Fred72z/ZX81/VP140/Clavier/Readme.md

# Clavier

Le Clavier minitel est très différent du clavier du ZX81. Aussi la disposition des touches est différentes. L'utilisation d'un PIC pour reproduire la matrice du clavier du ZX permet de rediriger certaines combinaisons de touches afin de simplificer l'utilisation du clavier minitel.

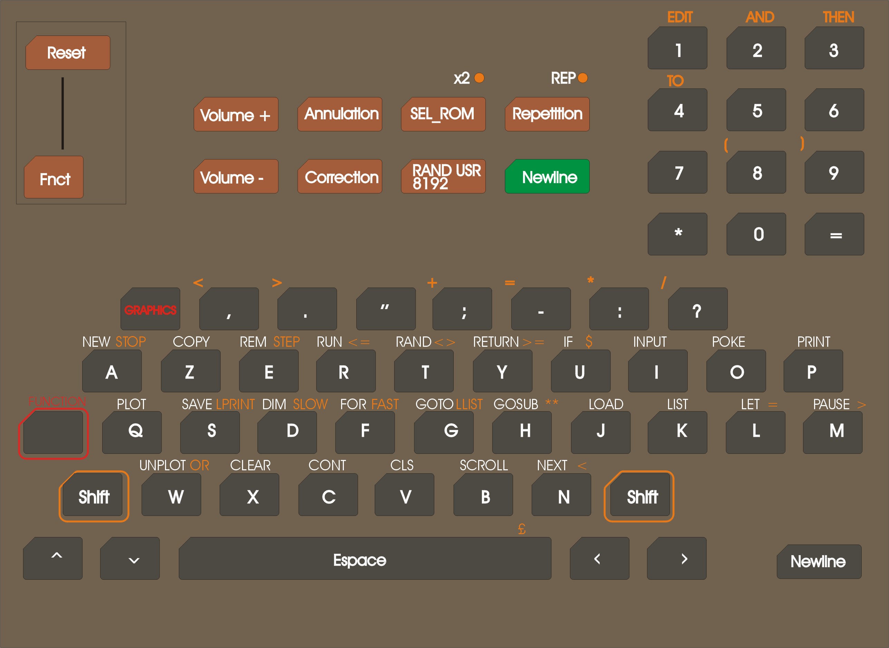
[picture p9: VP140/Clavier/map_clavier_minitel.jpg]
Map clavier Optional Title


Un appui simultané sur les touches Fcnt et Connexion/Fin permet de faire un RESET du ZX (appui prolongé).
Une petite led a été ajoutée au dessus de la touche Répétition pour indiquer l'activation de ce mode (désactivé à la mise sous tension).

# Ajout de la led

La led utilisée est une led 2mm à canon long (visible sur la photo). Il suffit de percer un trou de 2mm (1.9mm puis 2mm pour être juste à la cote).
Elle est recouverte de gaine thermorétractable pour éviter la lumière parasite sur les côtés. La résistances de limitation du courant doit être ajustée en fonction de la led choisie. Ici la résistance vaut 15k (La résistance est maintenant placée sur la platine principale).

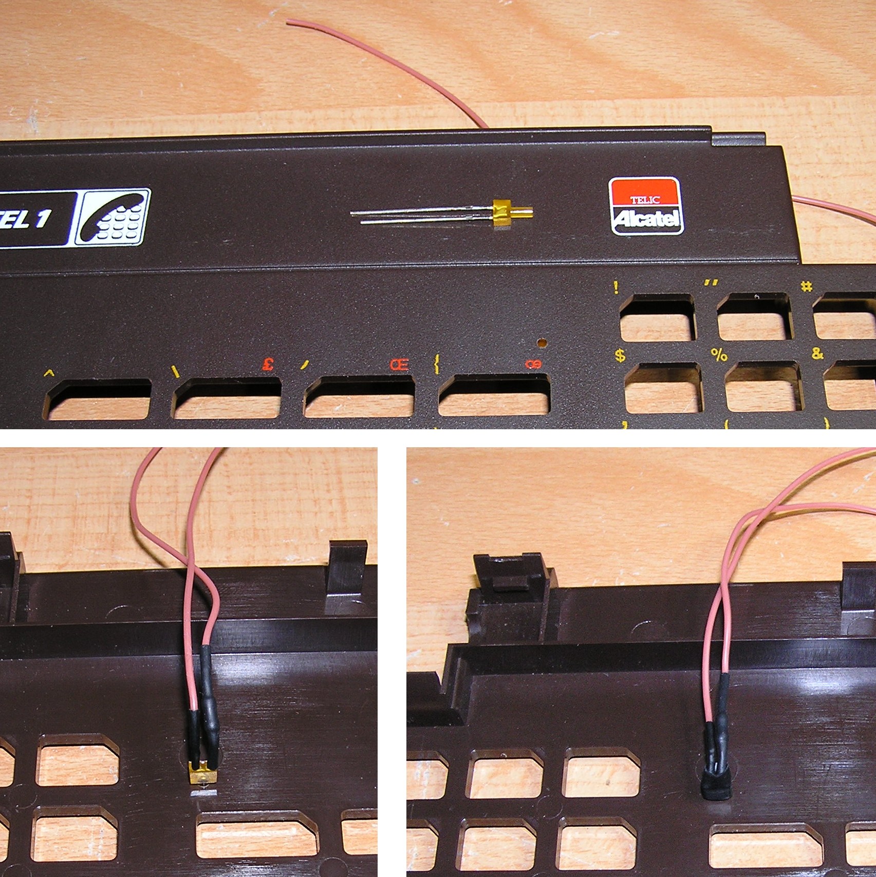
[picture p10: VP140/Clavier/led_clavier.jpg]
Led clavier Optional Title


# Rev 1.3
Pour la révision 1.3, il y a quelques changement:
- Une 2ème led a été ajoutée pour choisir 2 versions de la ROM du ZX.
- La touche Annulation permet d'effacer 10 caractères
- La touche RAND USR a été décalée
