Fred72z/ZX81/VP140/Cartouches/Readme.md

# Cartouches ROM

Les cartouches ROM ont une capacité de 256Ko (27c020 ou mieux W27E020). Elles prennent place dans la zone [$2000-$3FFF], soit 32 banques de 8Ko.
Le choix de la banque se fait par un écriture en mémoire à l'adresse $FFFF.

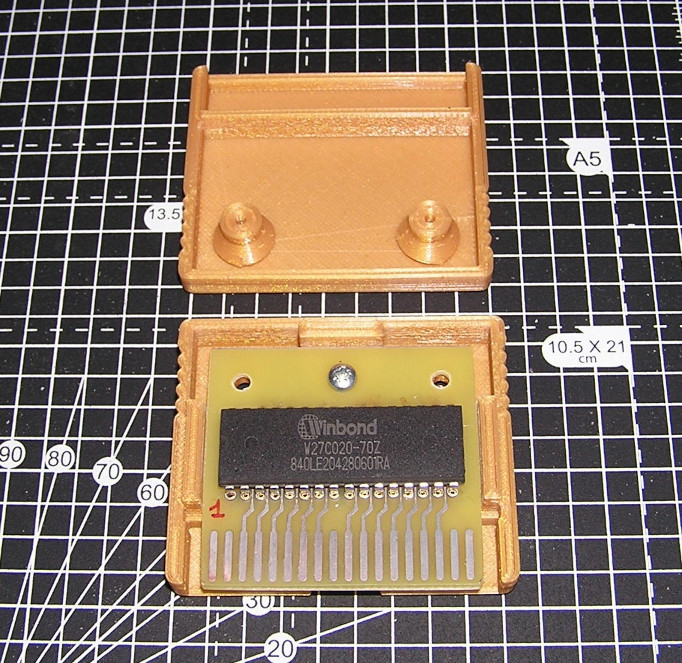
[picture p11: VP140/Cartouches/cartouche.jpg]
Cartouche Optional Title


# Cartouche N1
Cette première cartouche propose 18 programmes de jeux.

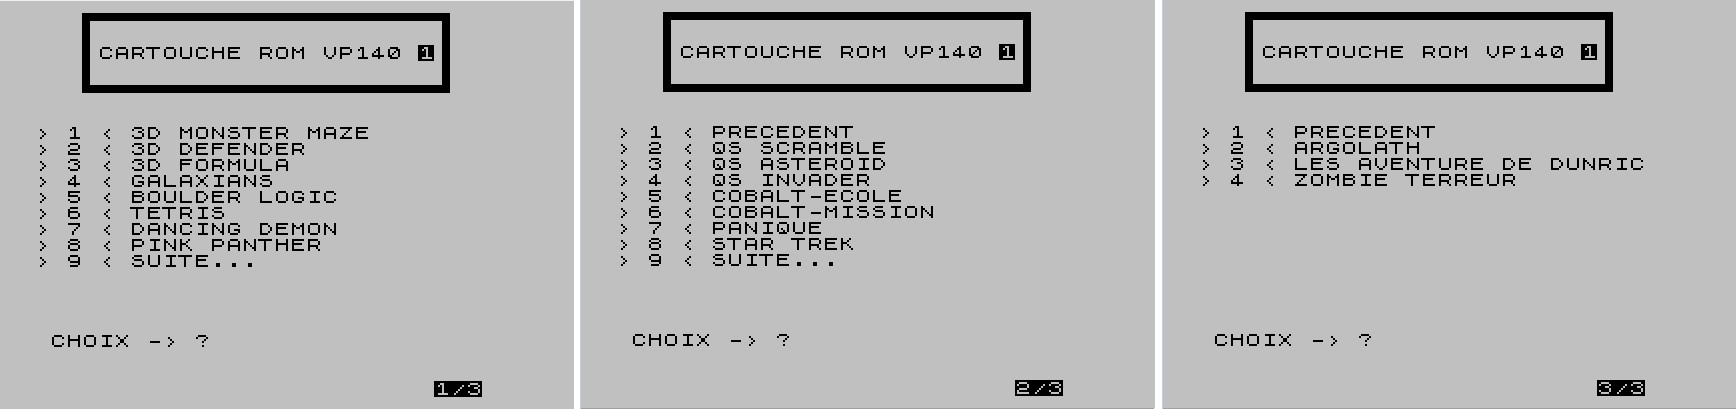
[picture p12: VP140/Cartouches/menu_N1.jpg]
Cartouche N1 Optional Title


# Cartouche N2
Cette deuxième cartouche propose 17 programmes de jeux.

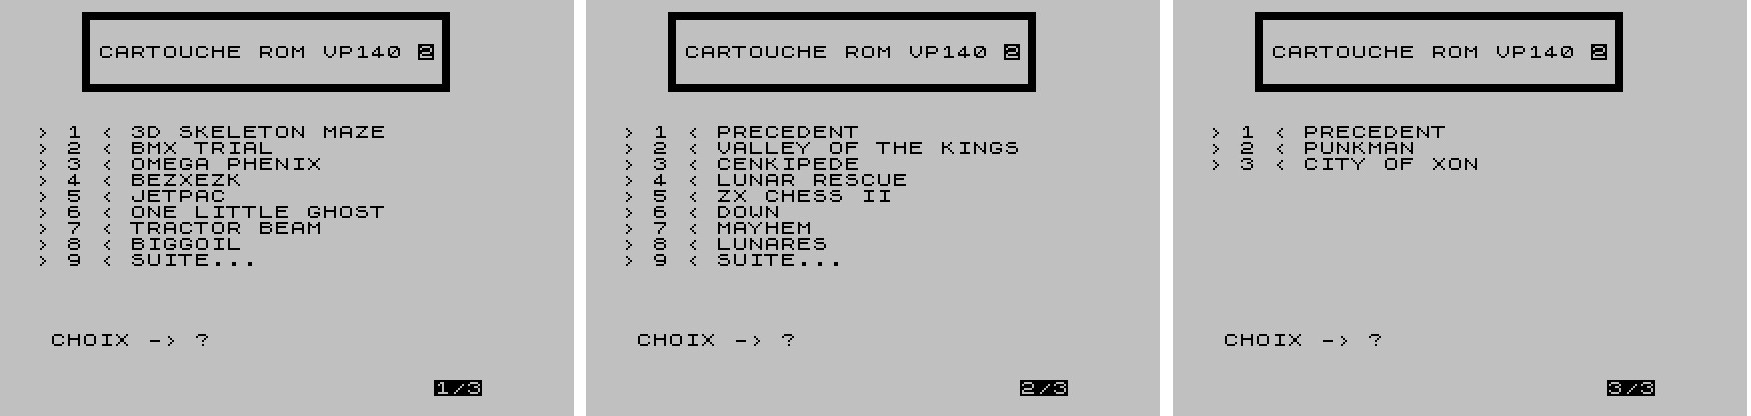
[picture p13: VP140/Cartouches/Menu_N2.jpg]
Cartouche N2 Optional Title


# Cartouche N3
Cette troisième cartouche propose un Juke-box avec 9 musiques du cpc. La fréquence du PSG étant différente, le timbre est plus élevé.

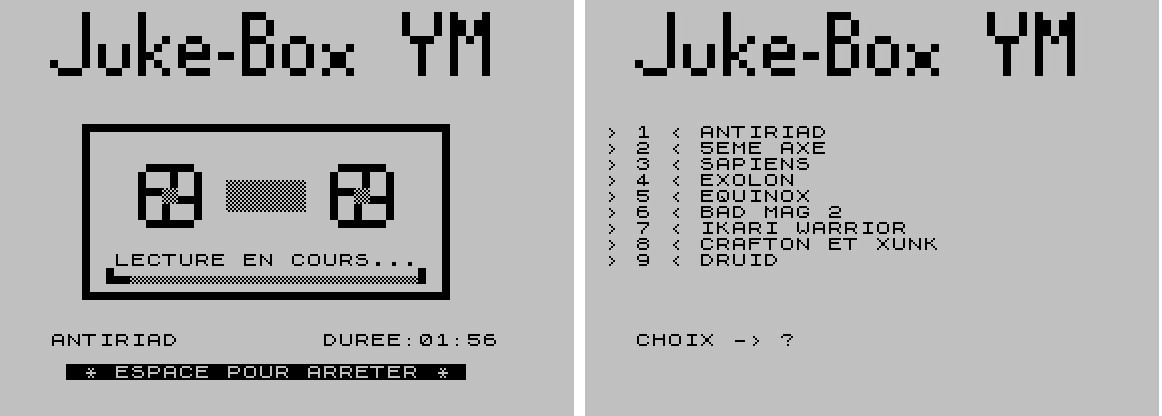
[picture p14: VP140/Cartouches/Menu_N3.jpg]
Cartouche N3 Optional Title


# Cartouche N4
Idem cartouche N3 avec d'autres musiques.

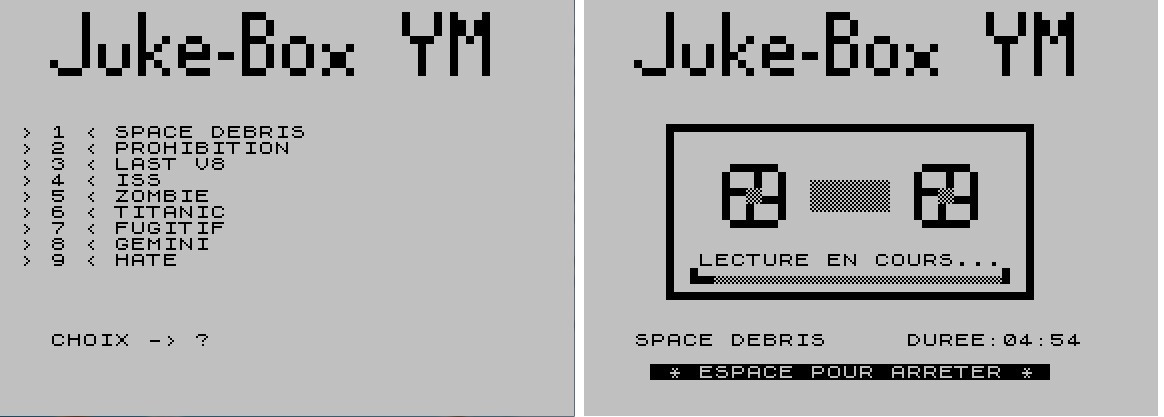
[picture p15: VP140/Cartouches/menu_N4.jpg]
Cartouche N4 Optional Title
