Fred72z/ZX81/VP140/CPLD/Readme.md

# CPLD

Le CPLD utilisé est un EPM7128S en boîtier PLCC84.
Le code (schématic et vhdl) a été compilé avec Quartus 13.0.
Les fichiers .pof contiennent les programmes prêt à écrire dans le composant.

Le répertoire source_1.6 contient le code pour la version 1.6 du ZX81+38 (connecteur JP3 inversé).

Le répertoire source_1.7 contient le code pour la version 1.7 du ZX81+38 (connecteur JP3 corrigé).
