Fred72z/ZX81/VP140/Kicad2013/Readme.md

# Platine principale

Platine principale Optional Title

# Platine auxiliaire

Platine auxiliaire Optional Title

# Cartouche ROM

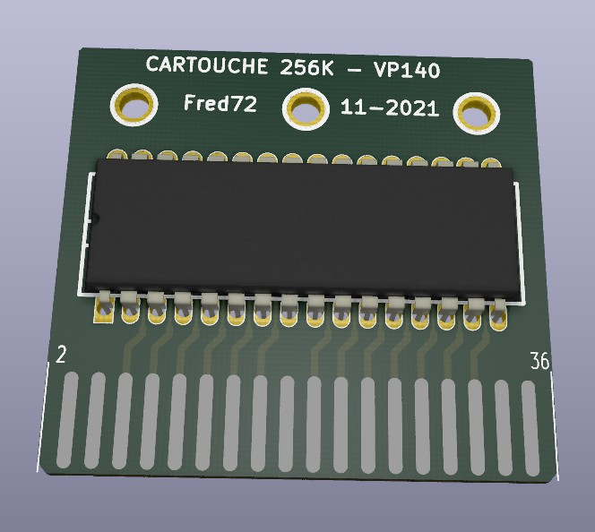
[picture p16: VP140/Kicad2013/cartouche_pcb.jpg]
Cartouche ROM Optional Title
