Fred72z/ZX81/VP140/Kicad2013/Auxiliaire/Implantation_Aux.png

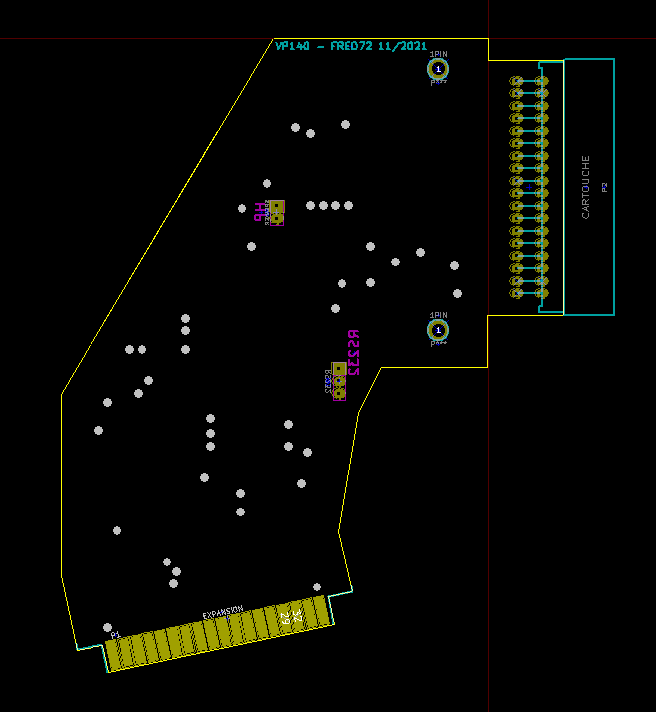
VP140/Kicad2013/Auxiliaire/Implantation_Aux.png
