Fred72z/ZX81/VP140/Kicad2013/Cartouche/Implantation_cartouche.png

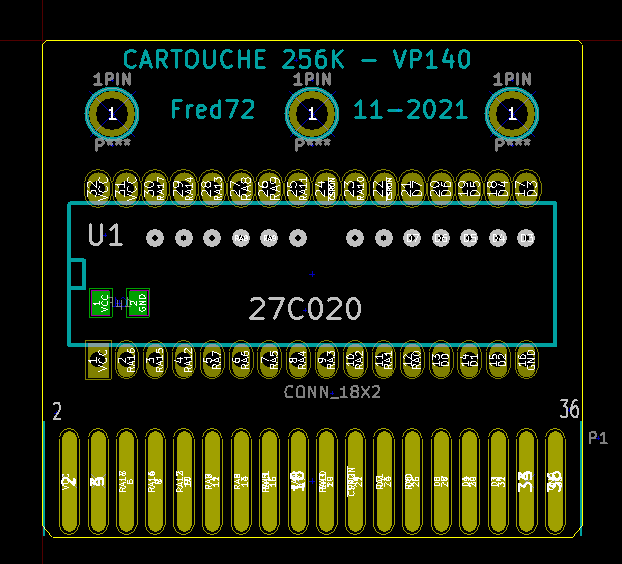
VP140/Kicad2013/Cartouche/Implantation_cartouche.png
