Fred72z/ZX81/VP140/Kicad2013/Principale/Implantation des composants.png

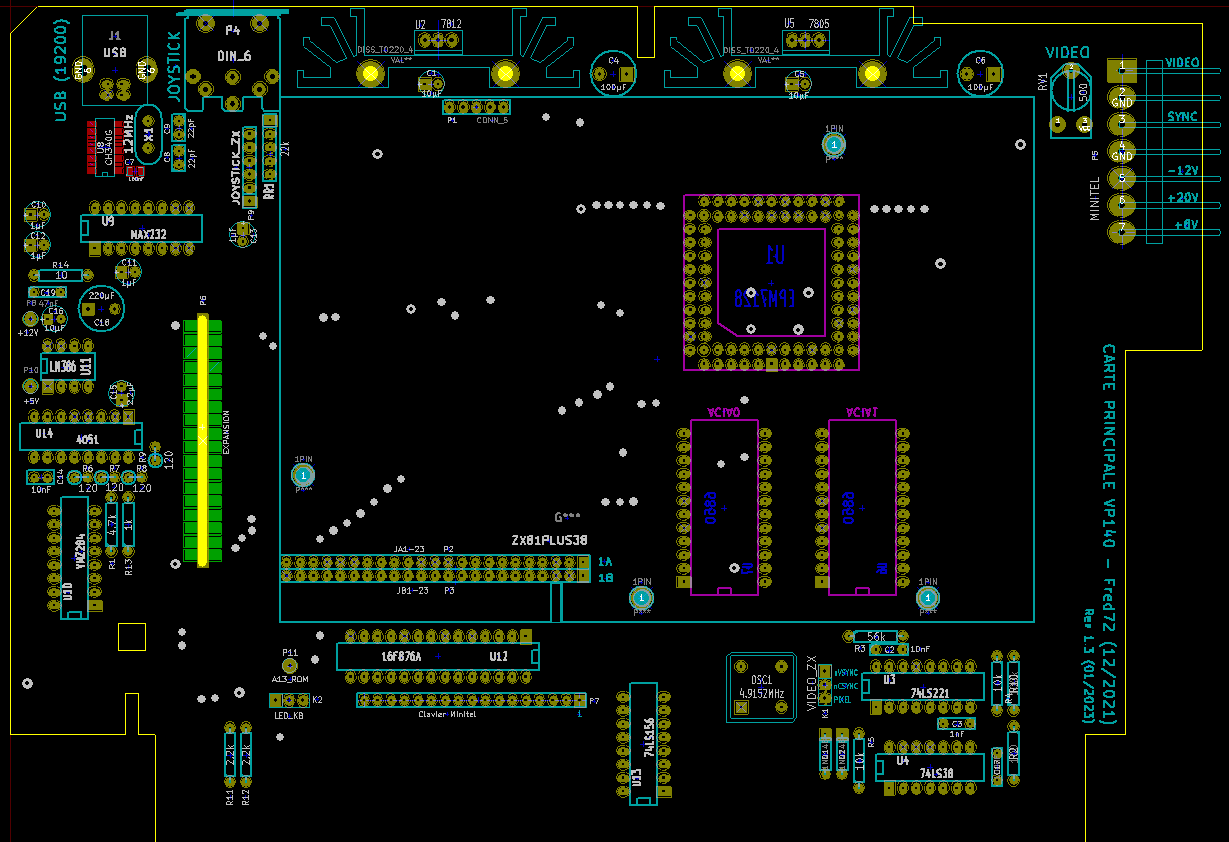
VP140/Kicad2013/Principale/Implantation des composants.png
