Fred72z/ZX81/VP140/Schemas_ver1.3/Schema VP140_rev1.3.pdf

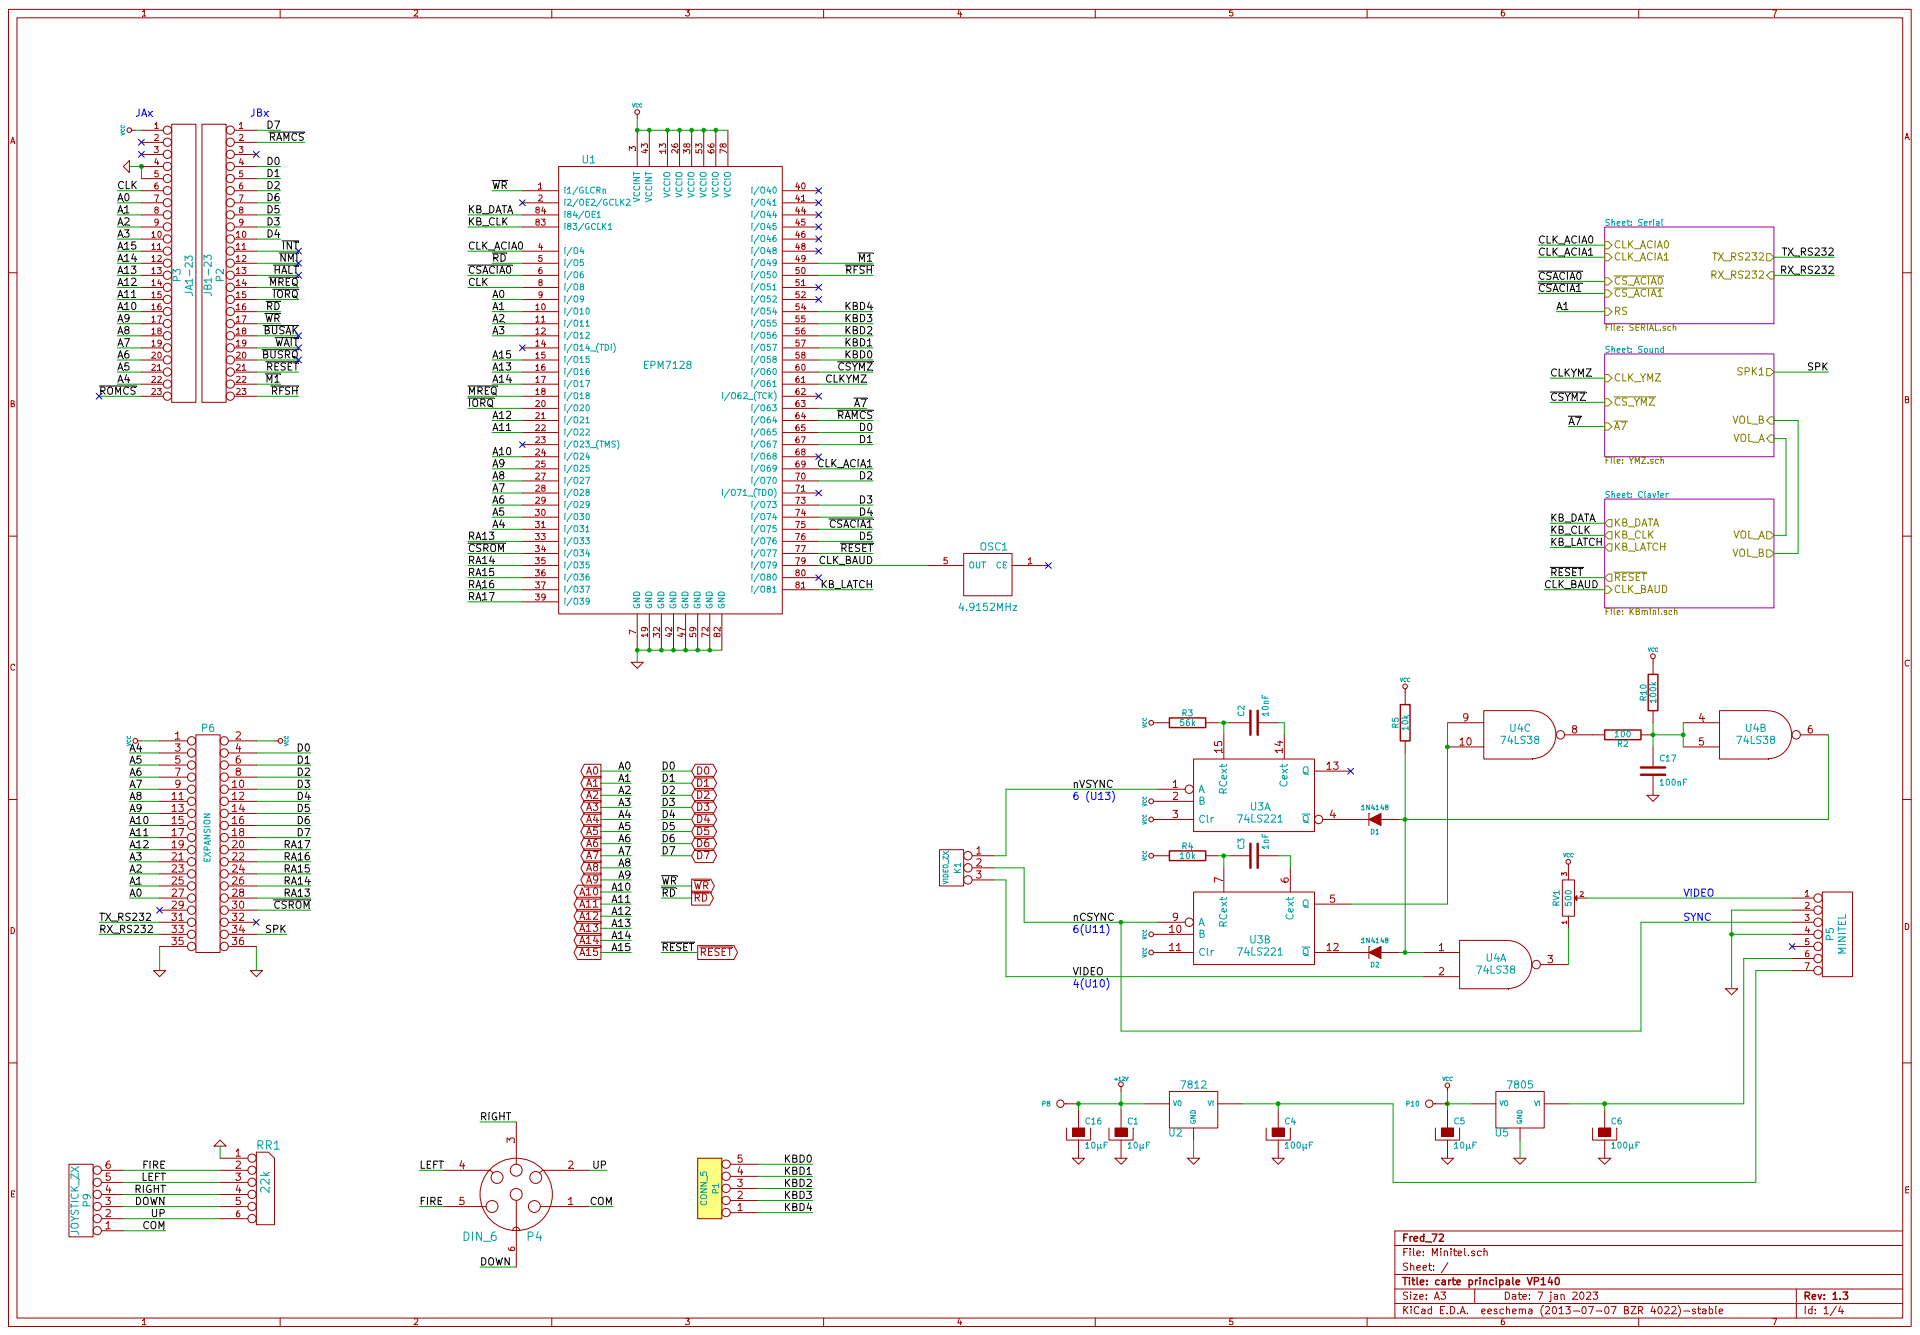
[picture p20: page 1]

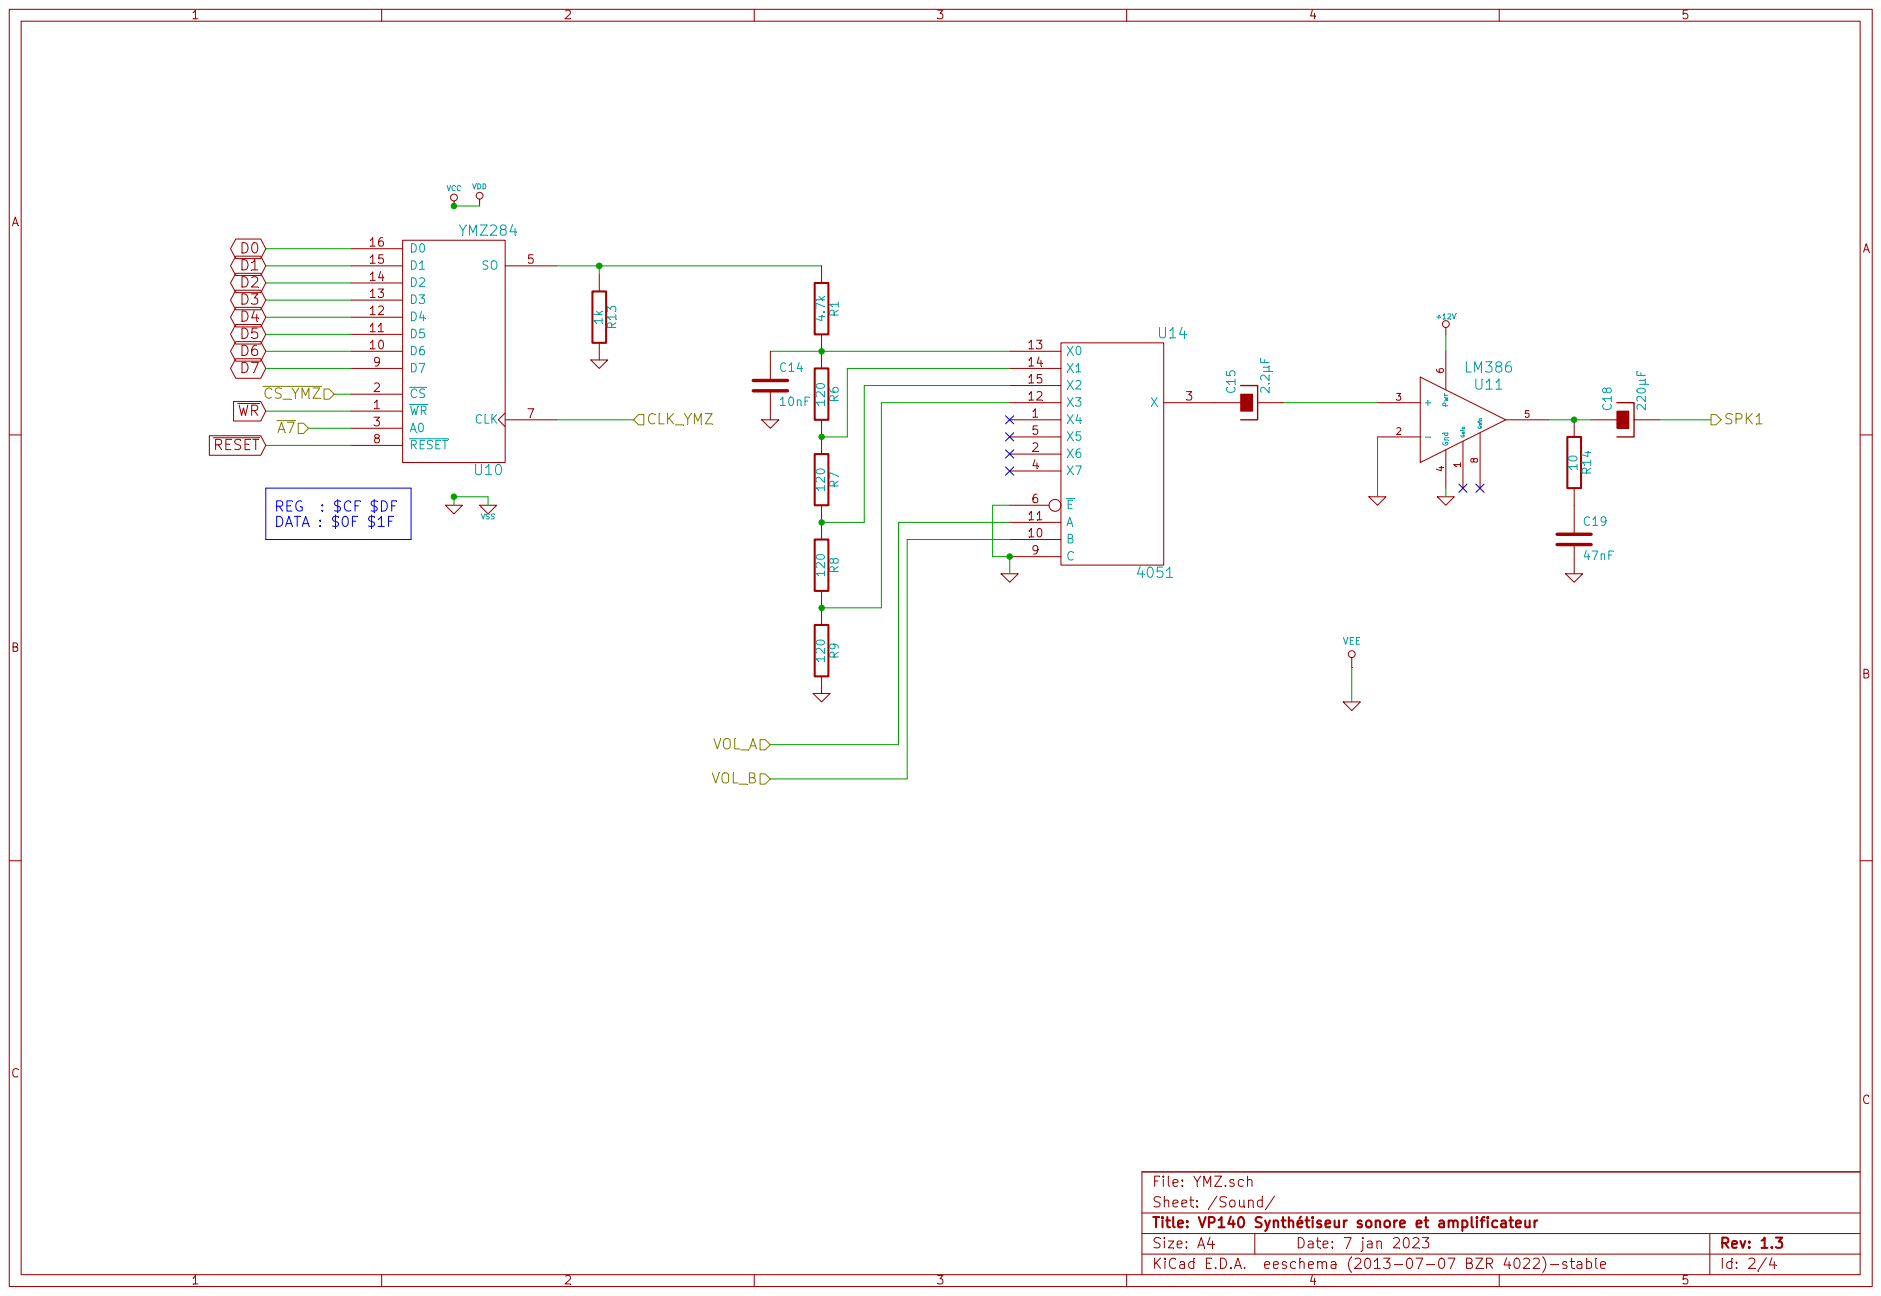
[picture p21: page 2]

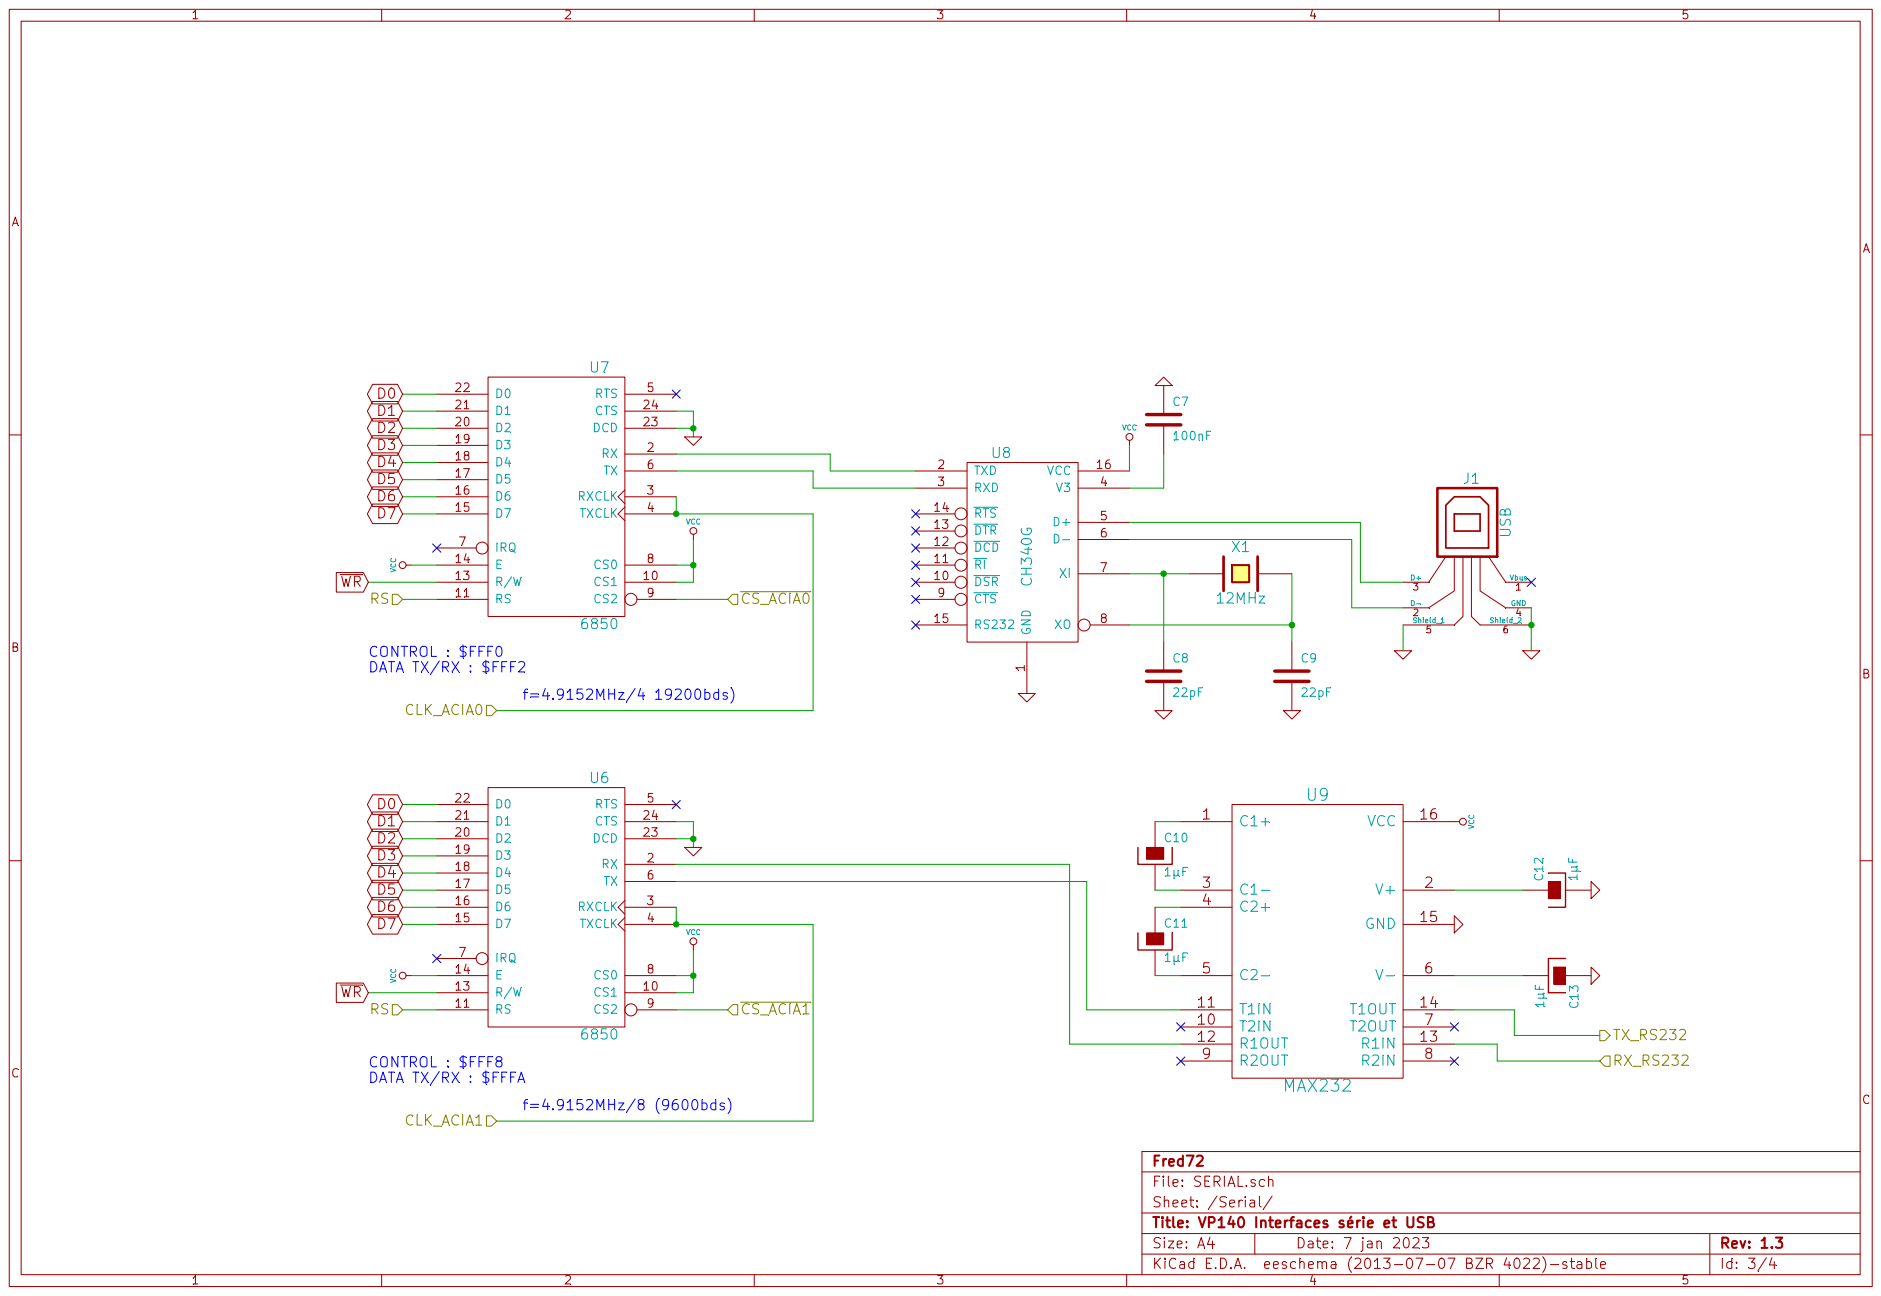
[picture p22: page 3]

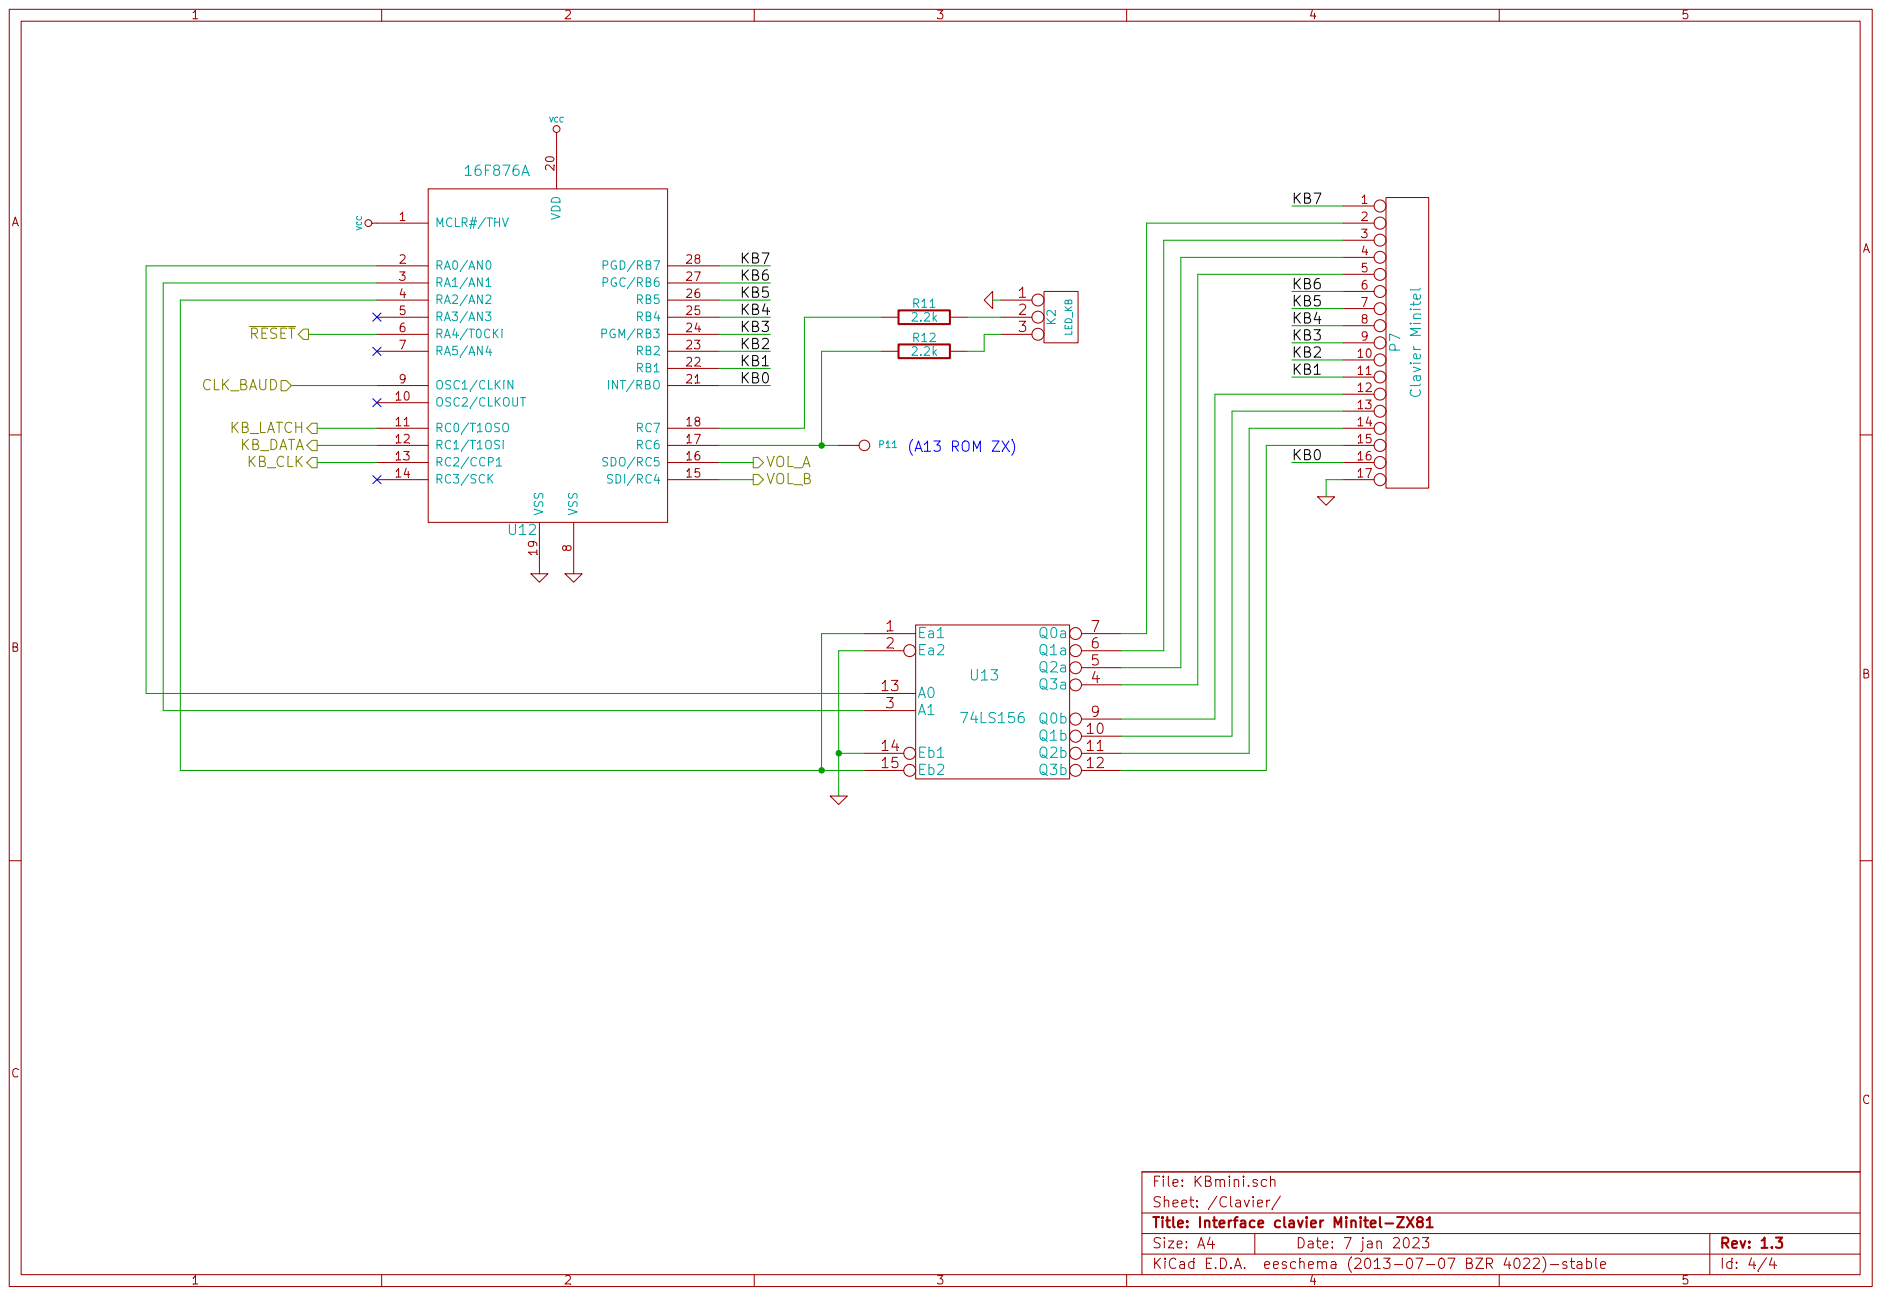
[picture p23: page 4]
