Fred72z/ZX81/VP140/Schemas_ver1.2/Schema_VP140_rev1.2.pdf

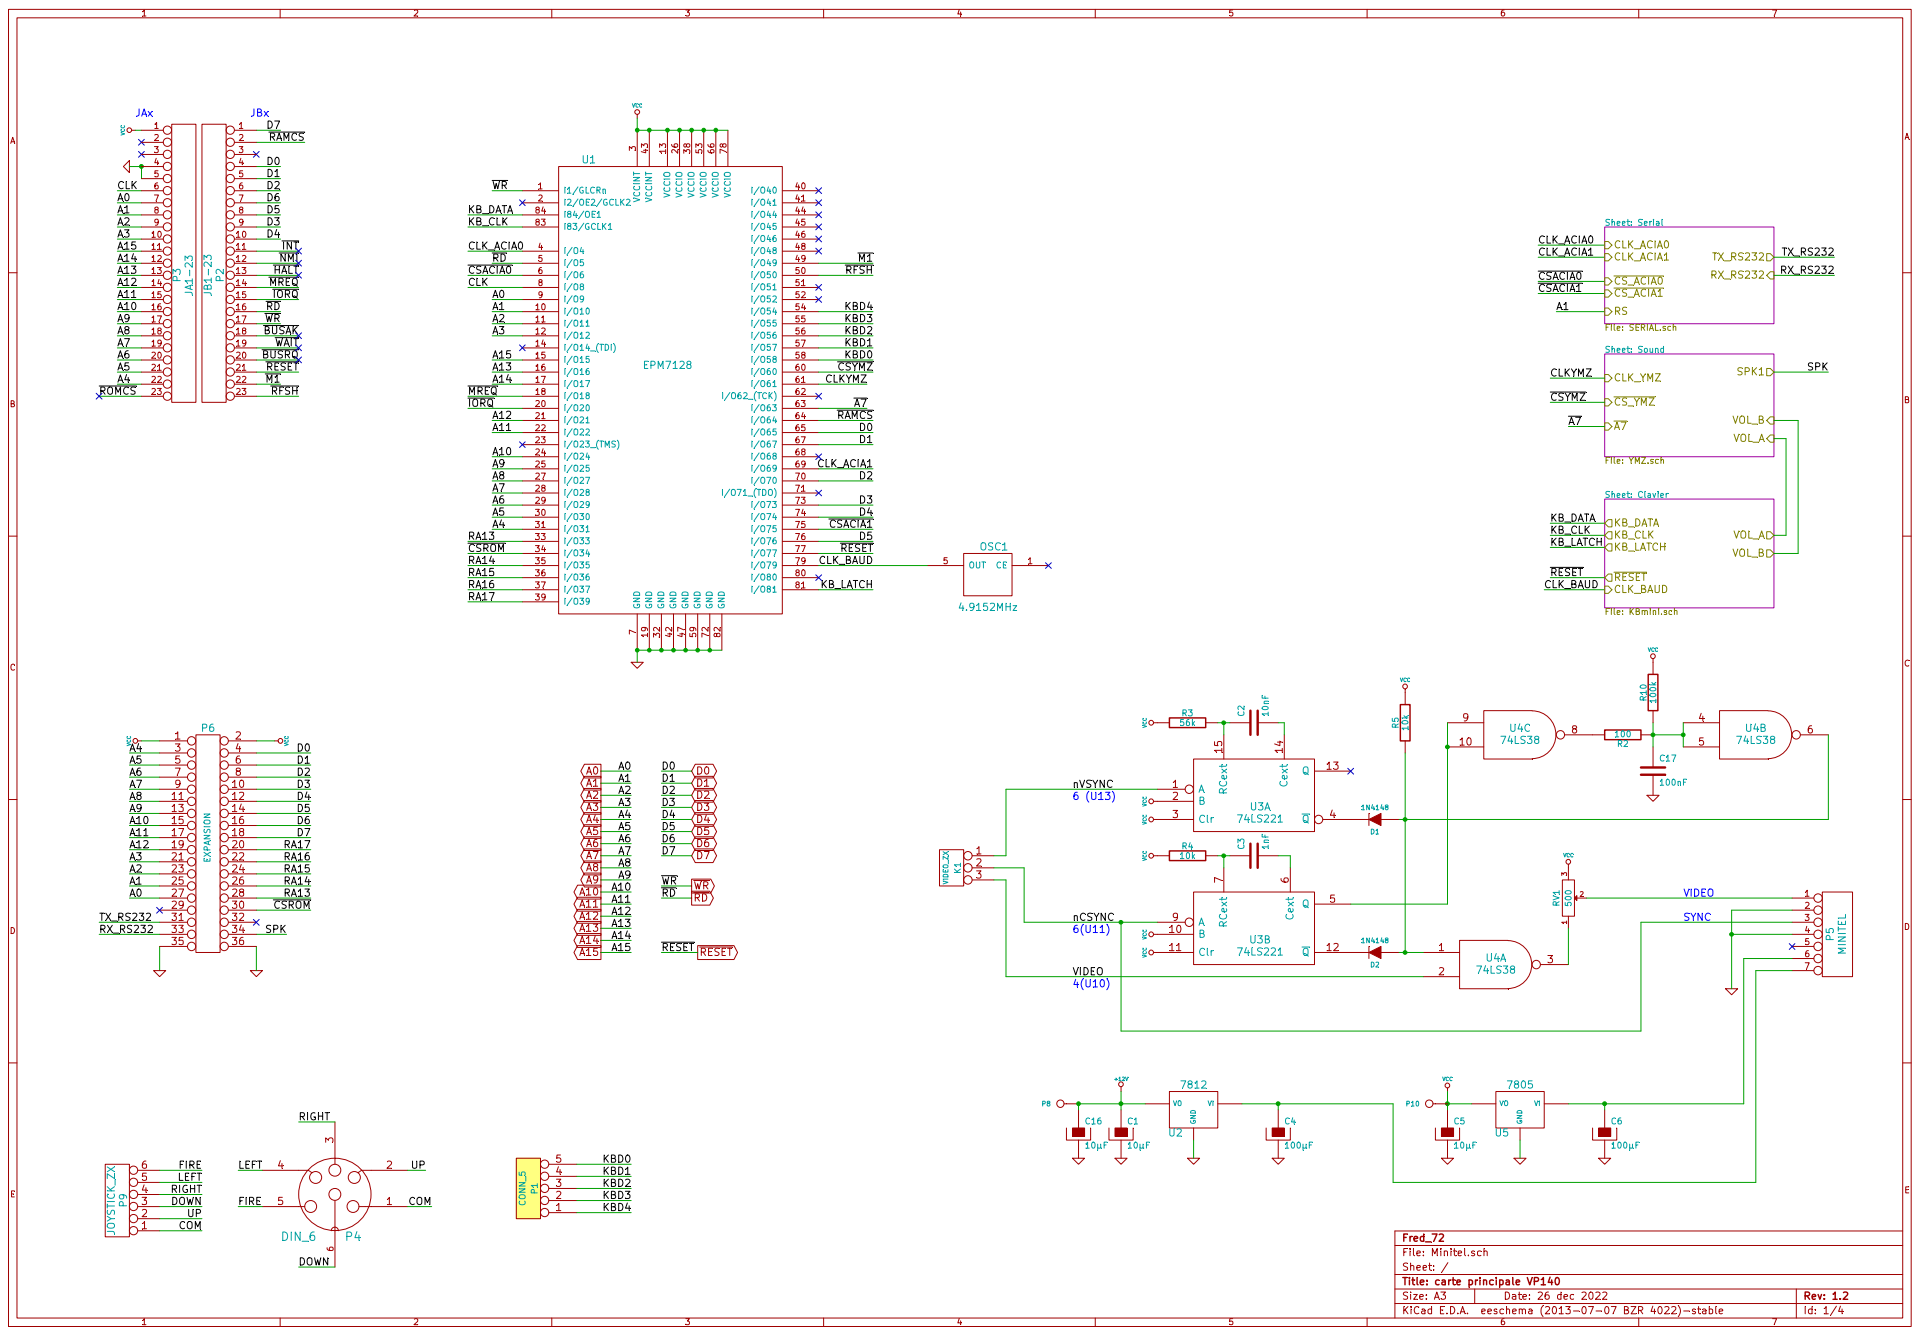
[picture p24: page 1]

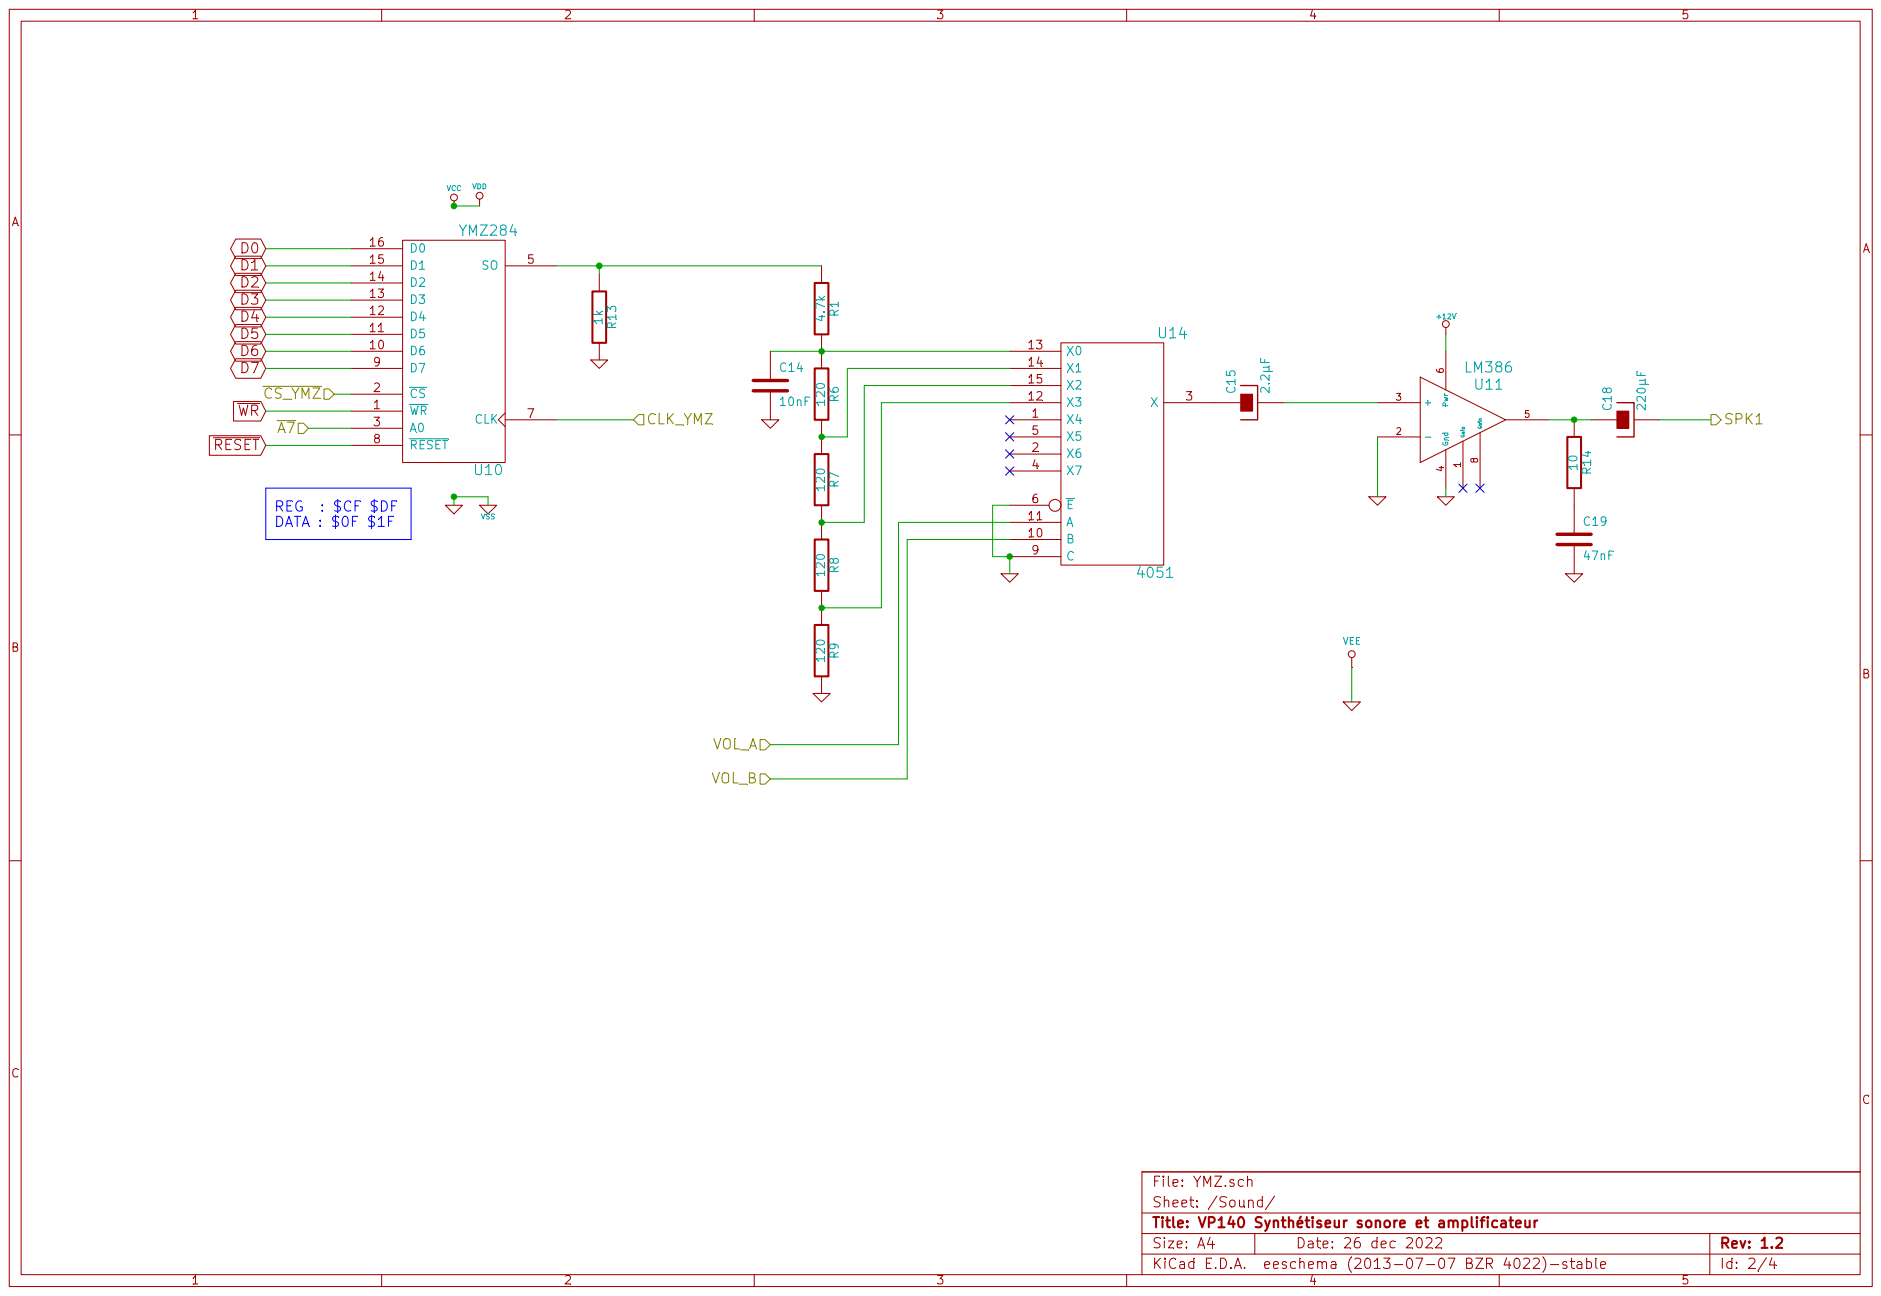
[picture p25: page 2]

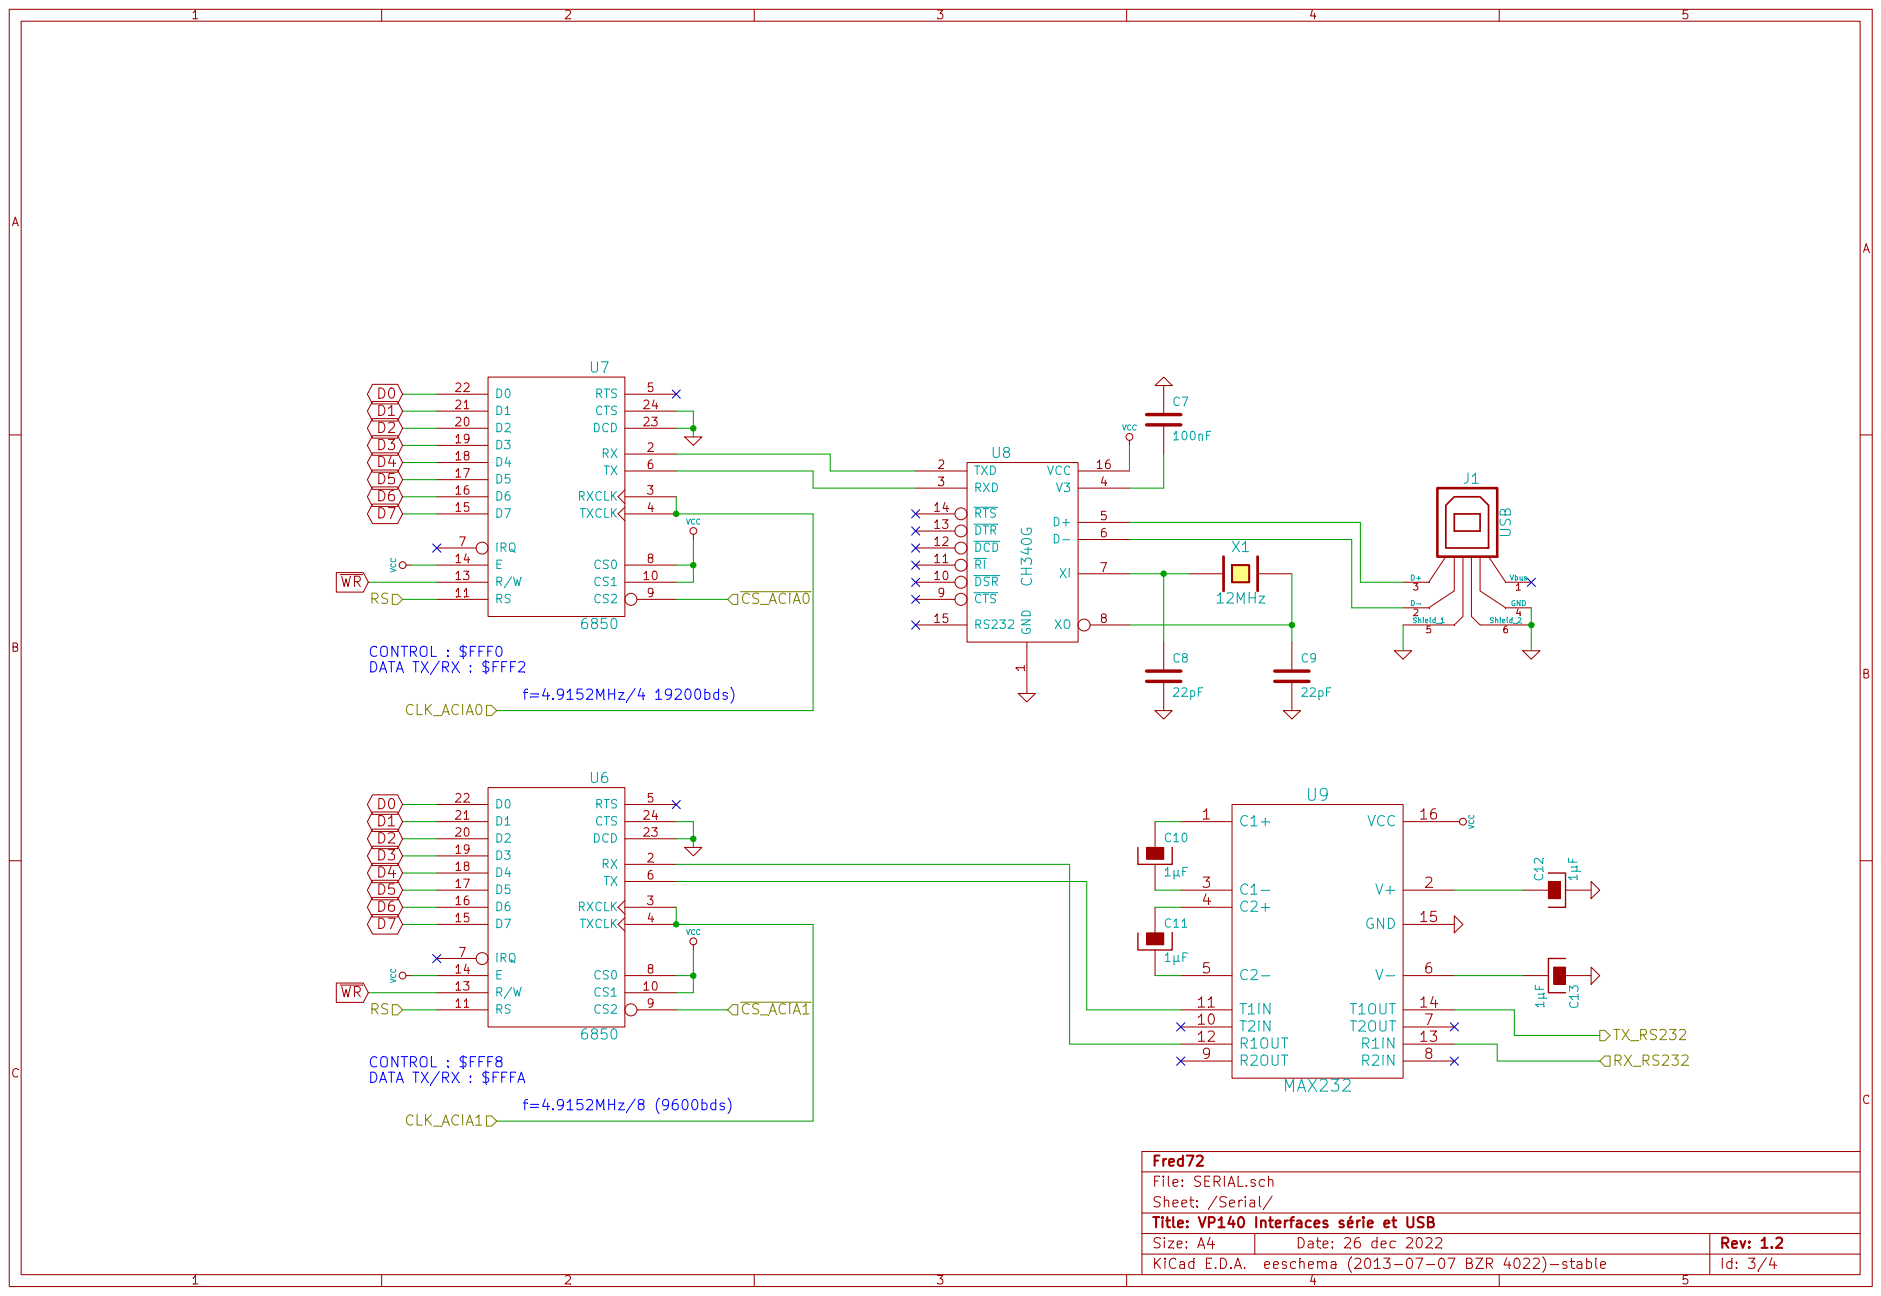
[picture p26: page 3]

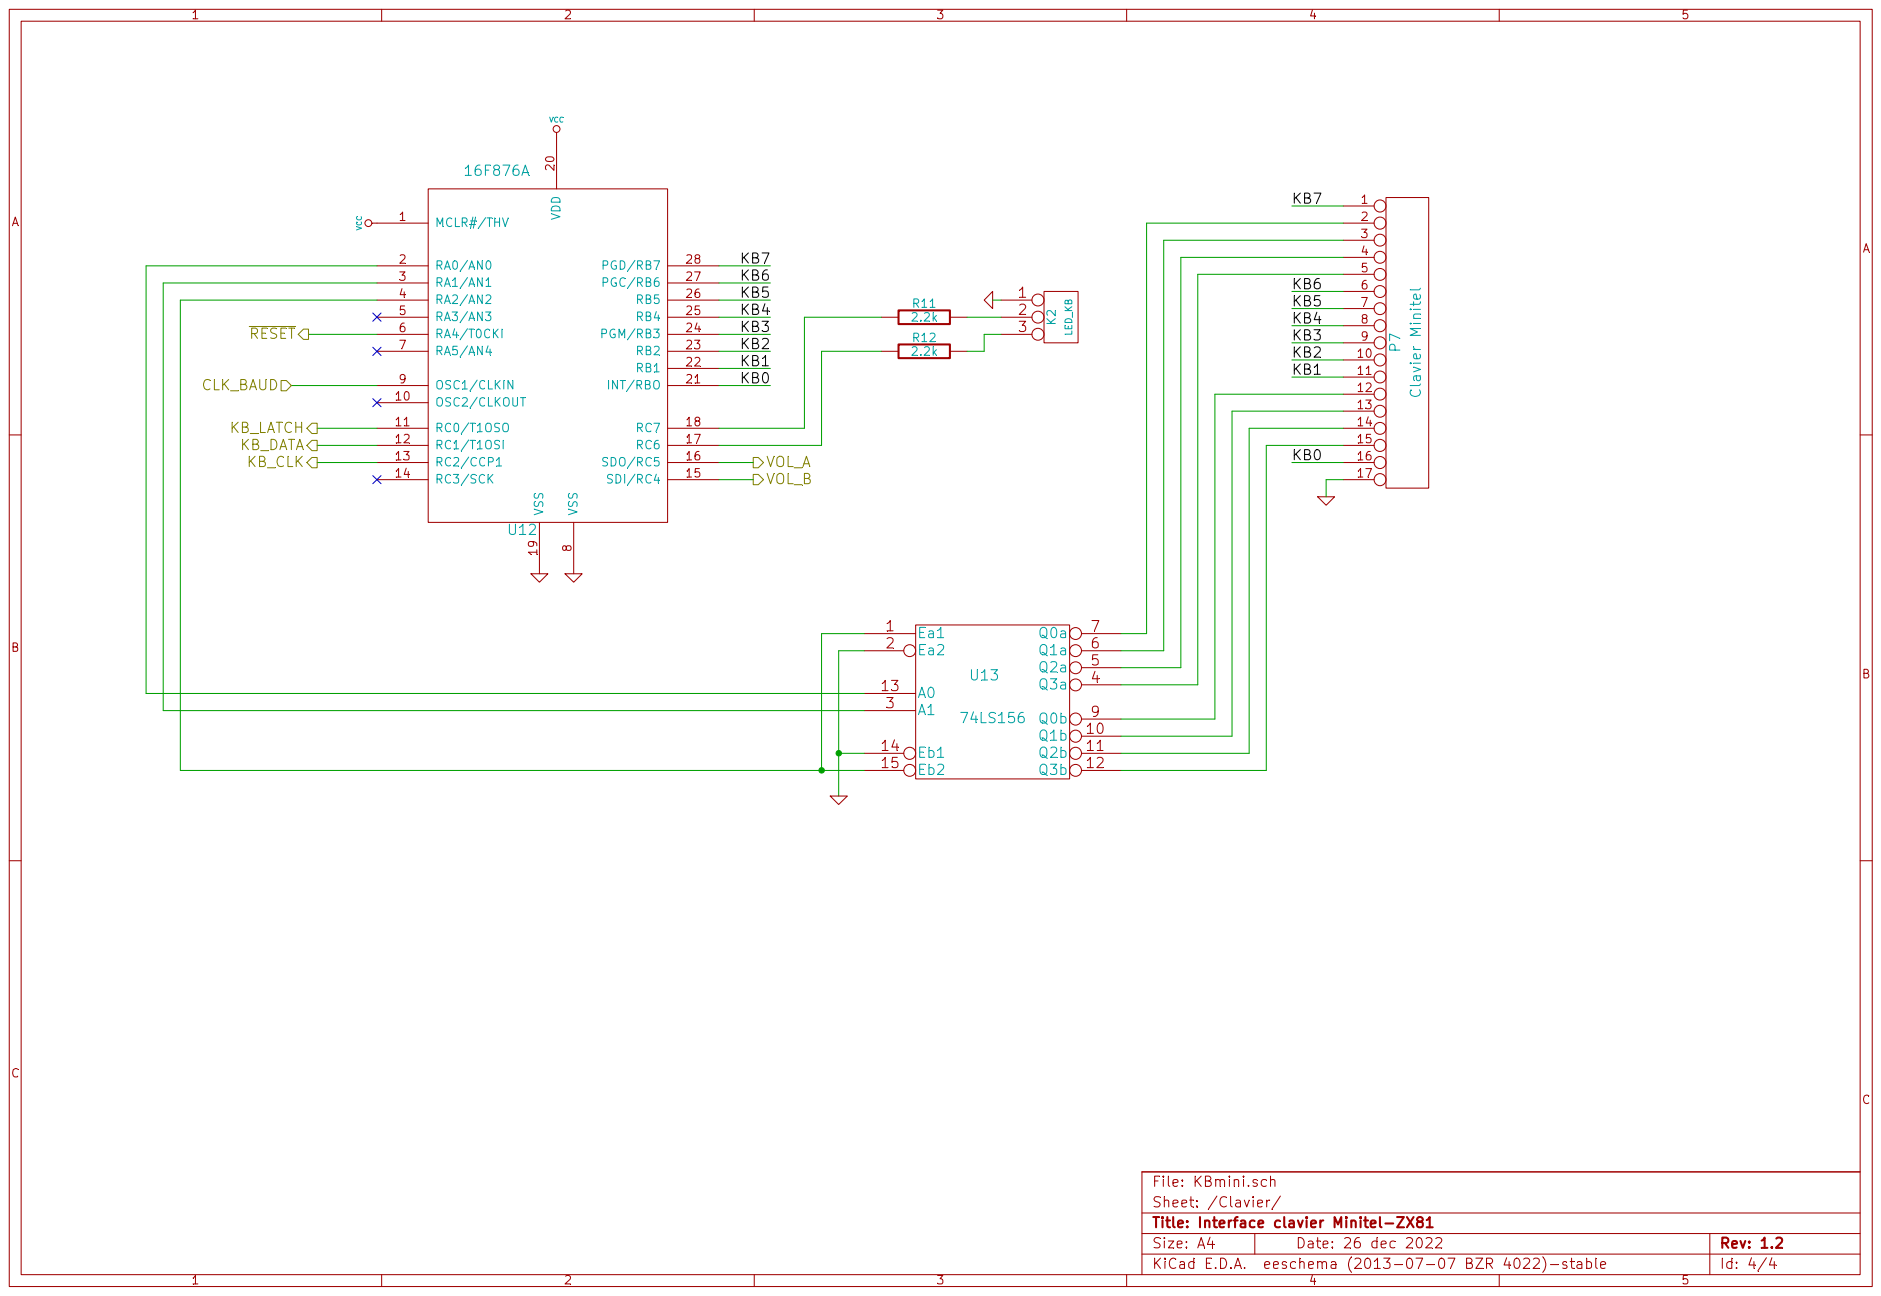
[picture p27: page 4]
