Fred72z/ZX81/VP140/Schemas_ver1.2/Schema_VP140_platine auxiliaire_rev1.2.pdf

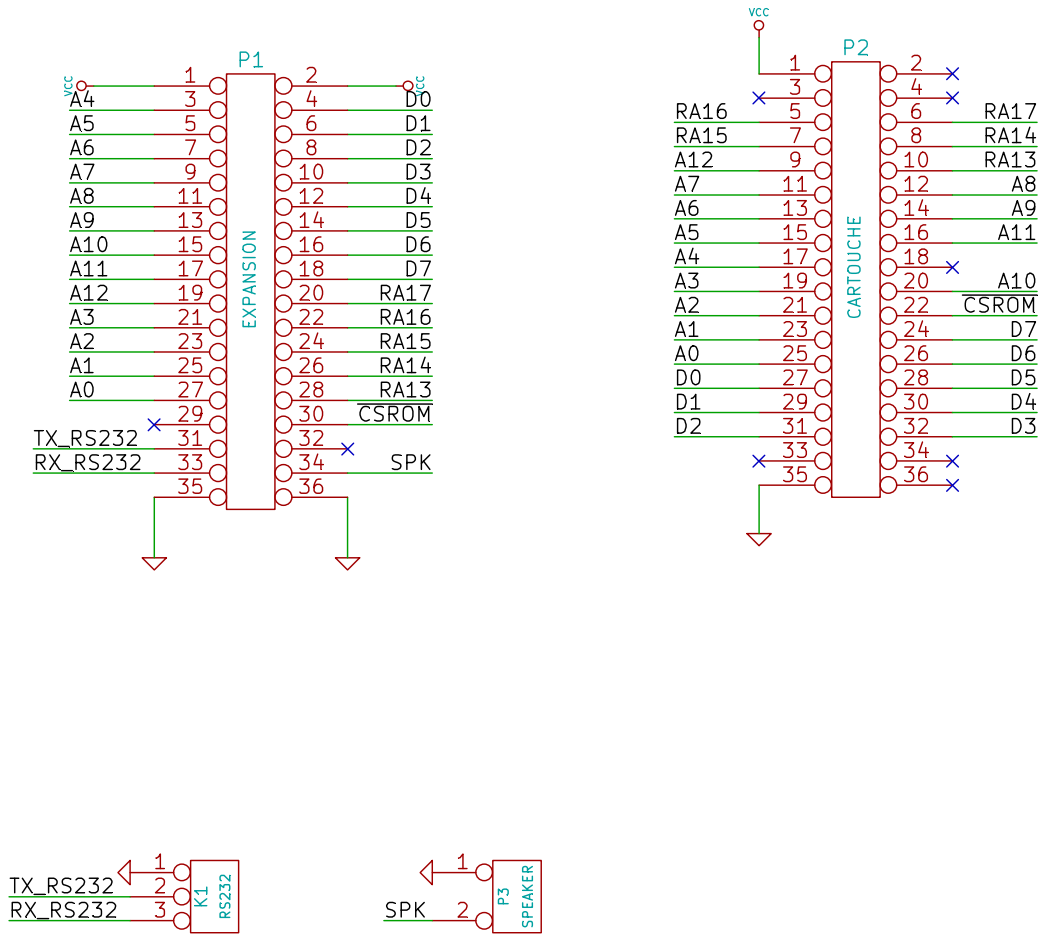
[picture p28: page 1]
