Fred72z/ZX81/VP140/Schemas_ver1.2/Schema_Cartouche_rev1.2.pdf

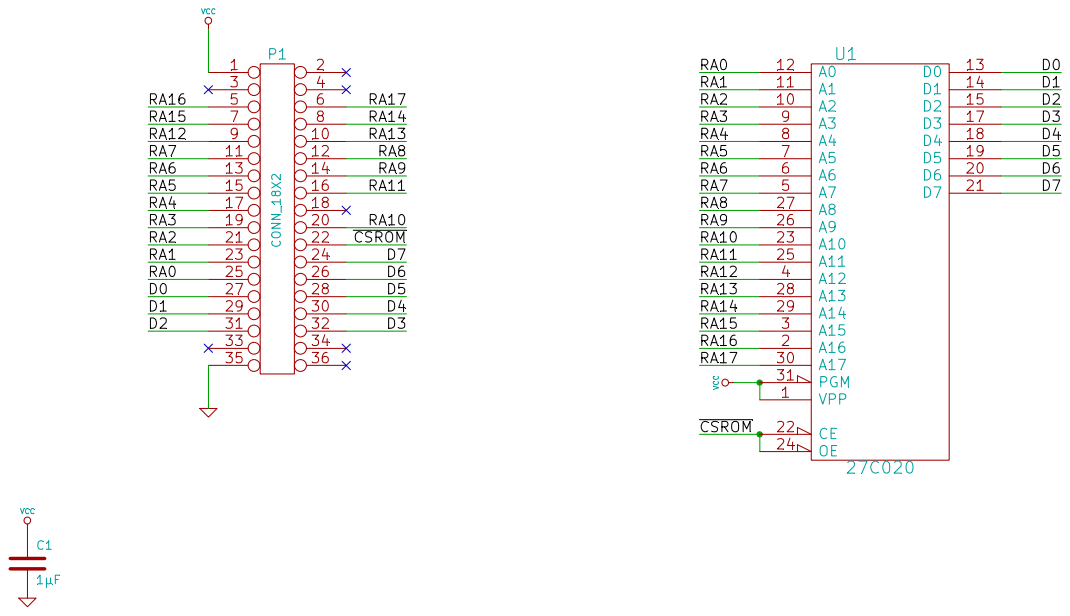
[picture p29: page 1]
